AhmadShah-1/Arduino-Based-Redundant-Transmission-for-Buoy-Networks/Designs/Information.txt

This folder contains diagrams in regards to the circuit design, with a custom-made LM339Mini module, mocked up on LTSplice
