AhmadShah-1/Arduino-Based-Redundant-Transmission-for-Buoy-Networks/Code/DataSurvey/Information.txt

DataSurvey:
calibration: Calibration code for temperature sensor (Validate 100 C, boiling water, and freezing water)
Combined: Tests both the temperature sensor and turbidity sensor
temperatureSensor: Tests temperature sensor usage
turbidity sensor: Tests turbidity sensor usage
