AhmadShah-1/Arduino-Based-Redundant-Transmission-for-Buoy-Networks/Code/PythonCode/Information.txt

Python1: Contains data to collect, graph, and save data

Voltage Depletion: Contains code to test the voltage depletion and total life of the batteries
