AhmadShah-1/Arduino-Based-Redundant-Transmission-for-Buoy-Networks/Code/Generator/1/voltage_plot2.png

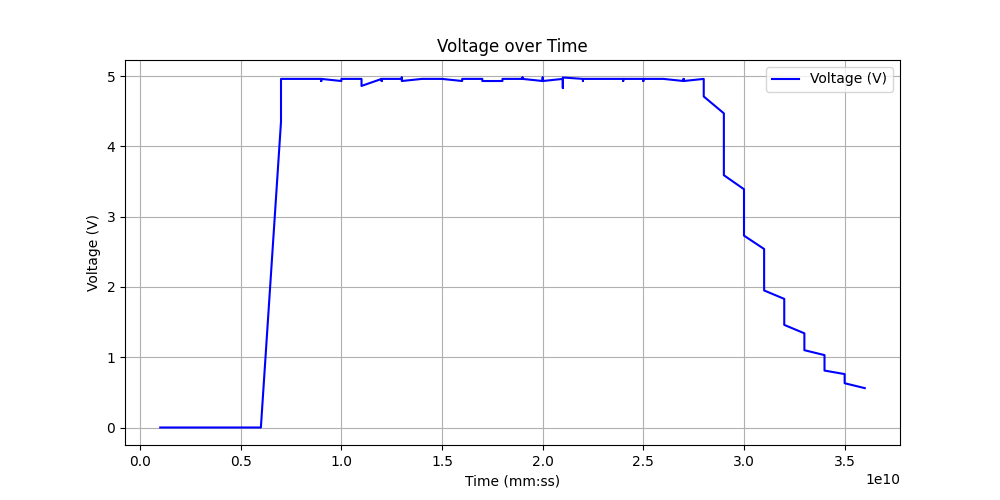
Code/Generator/1/voltage_plot2.png
