AhmadShah-1/Arduino-Based-Redundant-Transmission-for-Buoy-Networks/Code/Generator/1/WithRectifier/voltage_plot2_with_rectifier.png

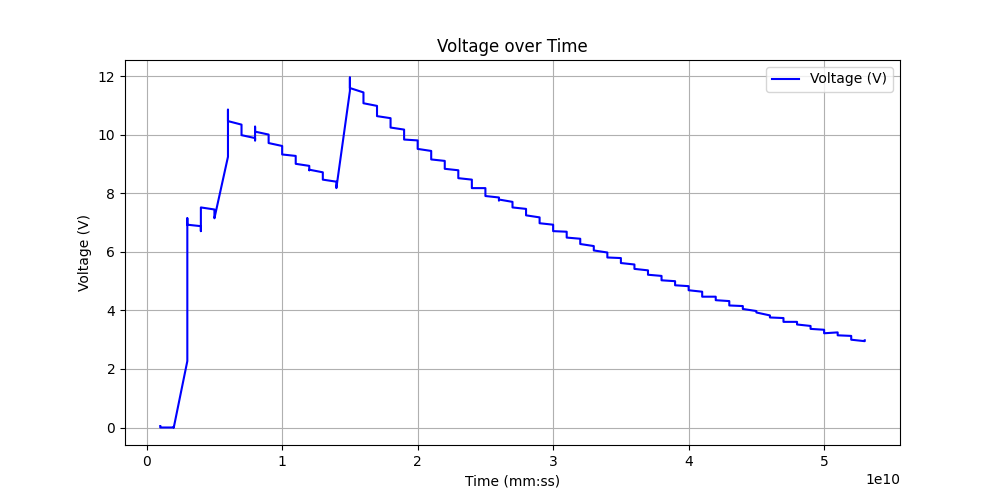
Code/Generator/1/WithRectifier/voltage_plot2_with_rectifier.png
