AhmadShah-1/Arduino-Based-Redundant-Transmission-for-Buoy-Networks/Designs/CircuitLTSplice.png

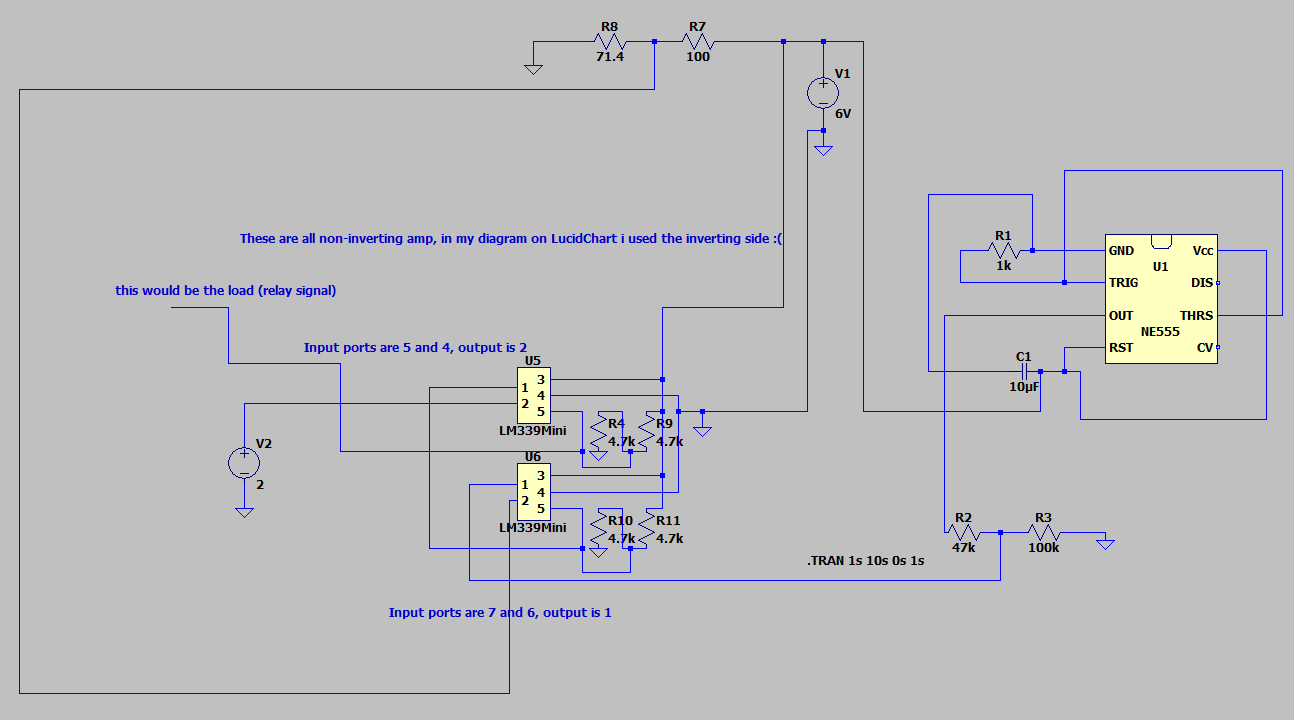
Designs/CircuitLTSplice.png
