AhmadShah-1/Arduino-Based-Redundant-Transmission-for-Buoy-Networks/Code/DataSurvey/Calibration/temperature_data.xlsx

Time | Temperature_C
2024-04-28 21:40:43 | 27.94
2024-04-28 21:40:45 | 27.94
2024-04-28 21:40:46 | 27.94
2024-04-28 21:40:48 | 30.12
2024-04-28 21:40:49 | 43.13
2024-04-28 21:40:51 | 53.69
2024-04-28 21:40:52 | 61.5
2024-04-28 21:40:54 | 67.31
2024-04-28 21:40:55 | 72.25
2024-04-28 21:40:57 | 76.37
2024-04-28 21:40:59 | 79.94
2024-04-28 21:41:00 | 82.94
2024-04-28 21:41:02 | 85.56
2024-04-28 21:41:03 | 87.62
2024-04-28 21:41:05 | 89.44
2024-04-28 21:41:06 | 91
2024-04-28 21:41:08 | 92.25
2024-04-28 21:41:09 | 93.37
2024-04-28 21:41:11 | 94.31
2024-04-28 21:41:13 | 95.12
2024-04-28 21:41:14 | 95.94
2024-04-28 21:41:16 | 96.56
2024-04-28 21:41:17 | 97.19
2024-04-28 21:41:19 | 97.69
2024-04-28 21:41:20 | 98.12
2024-04-28 21:41:22 | 98.5
2024-04-28 21:41:23 | 98.81
2024-04-28 21:41:25 | 99.12
2024-04-28 21:41:27 | 99.37
2024-04-28 21:41:28 | 99.62
2024-04-28 21:41:30 | 99.87
2024-04-28 21:41:31 | 100.06
2024-04-28 21:41:33 | 100.25
2024-04-28 21:41:34 | 100.37
2024-04-28 21:41:36 | 100.44
2024-04-28 21:41:37 | 100.37
2024-04-28 21:41:39 | 100.37
2024-04-28 21:41:41 | 100.37
2024-04-28 21:41:42 | 100.44
2024-04-28 21:41:44 | 100.5
2024-04-28 21:41:45 | 100.56
2024-04-28 21:41:47 | 100.69
2024-04-28 21:41:48 | 100.69
2024-04-28 21:41:50 | 100.75
2024-04-28 21:41:52 | 100.81
2024-04-28 21:41:53 | 100.81
2024-04-28 21:41:55 | 100.81
2024-04-28 21:41:56 | 100.87
2024-04-28 21:41:58 | 100.87
2024-04-28 21:41:59 | 100.94
2024-04-28 21:42:01 | 101
2024-04-28 21:42:02 | 101
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
2024-04-28 21:47:58 | 0.44
2024-04-28 21:48:00 | 0.44
2024-04-28 21:48:01 | 0.44
2024-04-28 21:48:03 | 0.44
2024-04-28 21:48:04 | 0.69
2024-04-28 21:48:06 | 0.94
2024-04-28 21:48:07 | 1.5
2024-04-28 21:48:09 | 2.13
2024-04-28 21:48:10 | 2.81
2024-04-28 21:48:12 | 3.5
2024-04-28 21:48:13 | 4.19
