AhmadShah-1/Arduino-Based-Redundant-Transmission-for-Buoy-Networks/Code/Generator/1/TestWithDrill(MAX)/voltage_plot.png

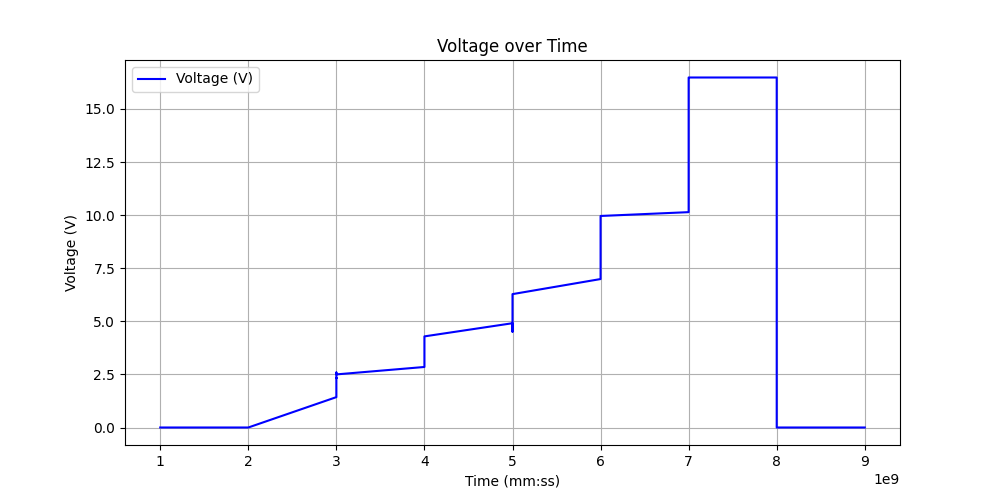
Code/Generator/1/TestWithDrill(MAX)/voltage_plot.png
