AhmadShah-1/Arduino-Based-Redundant-Transmission-for-Buoy-Networks/Code/Recieving/Recieving2/Recieving2.ino

#include <SPI.h>
#include <nRF24L01.h>
#include <RF24.h>

RF24 radio(7, 8); // CE, CSN

const byte address[6] = "00001";

void setup() {
  Serial.begin(9600);
  radio.begin();
  radio.openReadingPipe(0, address);
  radio.setPALevel(RF24_PA_MIN);
  radio.startListening();

  if (!radio.isChipConnected()) {
    Serial.println("nRF24L01 not detected. Please check connections.");
    while (1); // Stop the program here
} else {
    Serial.println("nRF24L01 detected!");
}

}

void loop() {
  if (radio.available()) {
    char text[32] = "";
    radio.read(&text, sizeof(text));
    Serial.println(text);
  }
}
