AhmadShah-1/Arduino-Based-Redundant-Transmission-for-Buoy-Networks/Code/Recieving/Recieving3/Recieving3.ino

#include <SPI.h>
#include <nRF24L01.h>
#include <RF24.h>

RF24 radio(7, 8); // CE, CSN pins
const byte address[6] = "00001";

struct DataReceived {
  float tempC;
  float tempF;
  int turbidity;
  unsigned long elapsedTime;
};

DataReceived data;

void setup() {
  Serial.begin(9600);
  radio.begin();
  radio.openReadingPipe(0, address);
  radio.setPALevel(RF24_PA_MIN);
  radio.startListening();
}

void loop() {
  if (radio.available()) {
    radio.read(&data, sizeof(DataReceived));
    Serial.print("Temperature: ");
    Serial.print(data.tempC);
    Serial.print(" °C | ");
    Serial.print(data.tempF);
    Serial.println(" °F");
    Serial.print("Turbidity: ");
    Serial.println(data.turbidity);
    Serial.print("Time Elapsed: ");
    Serial.println(data.elapsedTime);
  }
}
