AhmadShah-1/Arduino-Based-Redundant-Transmission-for-Buoy-Networks/(commit log)

2024-07-01 Added all Oceanic Data
    [processed_data.xlsx, sensor_data1.xlsx, sensor_data7cm.4hz.xlsx, sensor_data7cm.4hzsecond.xlsx, sensor_data7cm.4hzthird.xlsx, temperature_data.xlsx, voltage_data.csv, voltage_data.xlsx]
2024-10-17 added new code to correctly send data, as previous code was faulty for some unknown reason
    [sensor_data7cm_4hz_third.xlsx]
2025-01-07 New Recieving and Transmitting Code for Current
2025-01-07 Updated buffer size
    updated buffer size to account for new current measurment
2025-01-07 Measuring Current
    Updated Code to measure current
    [sensor_data7cm_4hz_third.xlsx]
2025-01-07 Updated to show Power
    [sensor_data7cm_4hz_third.xlsx]
2025-01-07 Graph only power
